LafeLabs/trashScope/geometron/symbolfeed/symbol1676215833.png

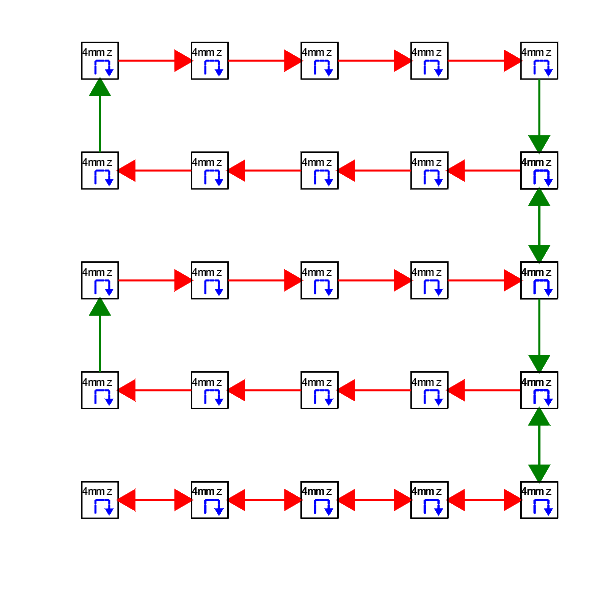
geometron/symbolfeed/symbol1676215833.png
