LafeLabs/trashScope/geometron/symbolfeed/symbol1676500387.png

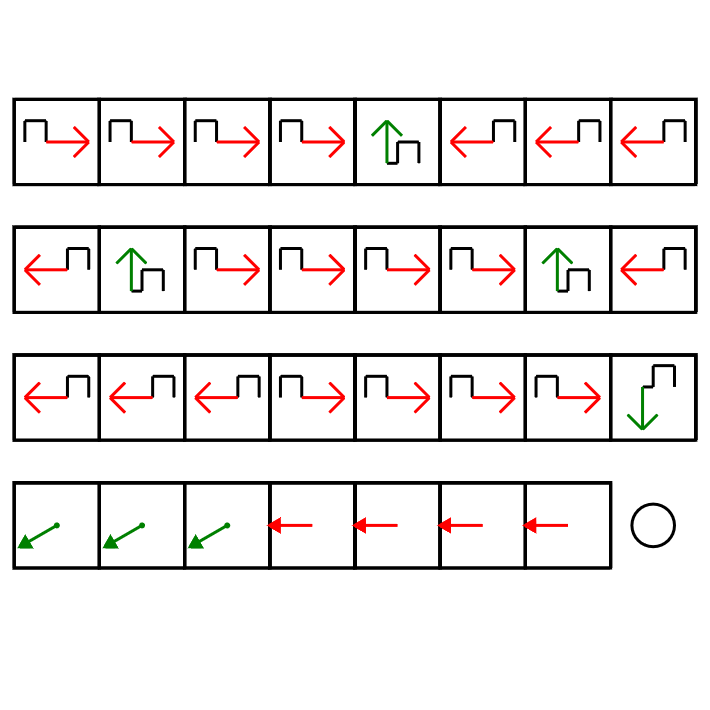
geometron/symbolfeed/symbol1676500387.png
