LafeLabs/trashScope/geometron/symbolfeed/symbol1676500932.png

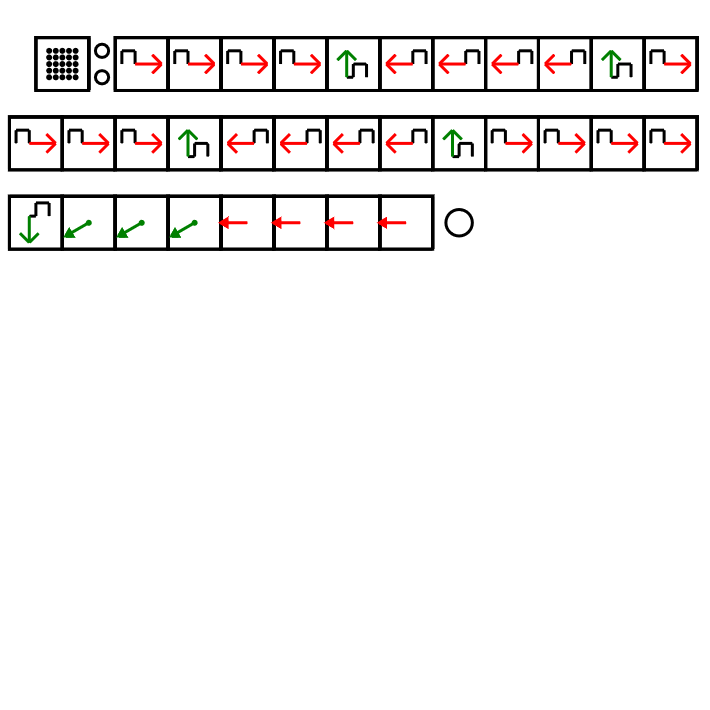
geometron/symbolfeed/symbol1676500932.png
