LafeLabs/trashScope/geometron/symbolfeed/symbol1676500959.png

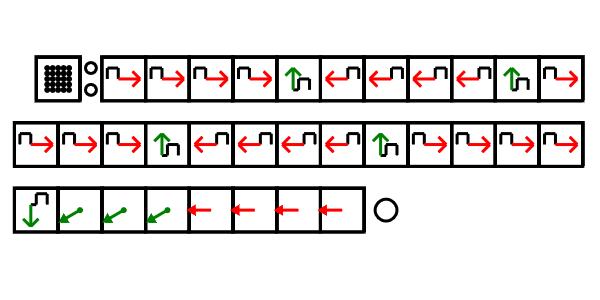
geometron/symbolfeed/symbol1676500959.png
