LafeLabs/trashScope/geometron/symbolfeed/symbol1676501370.png

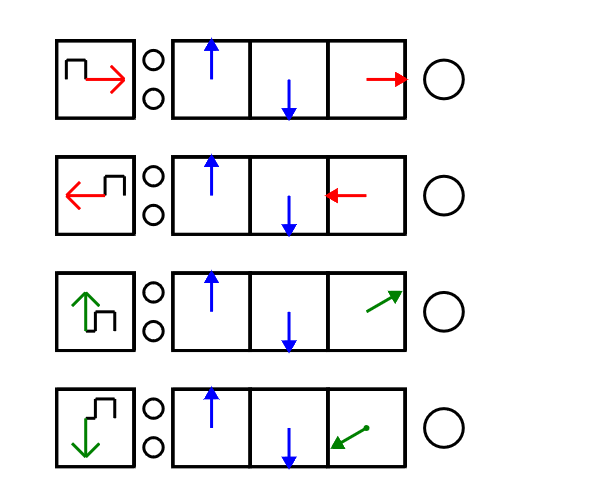
geometron/symbolfeed/symbol1676501370.png
