LafeLabs/trashScope/pcb/arduino-shield-xyz-stepper-v3.brd

## EAGLE design pcb/arduino-shield-xyz-stepper-v3.brd (2023-02-11)

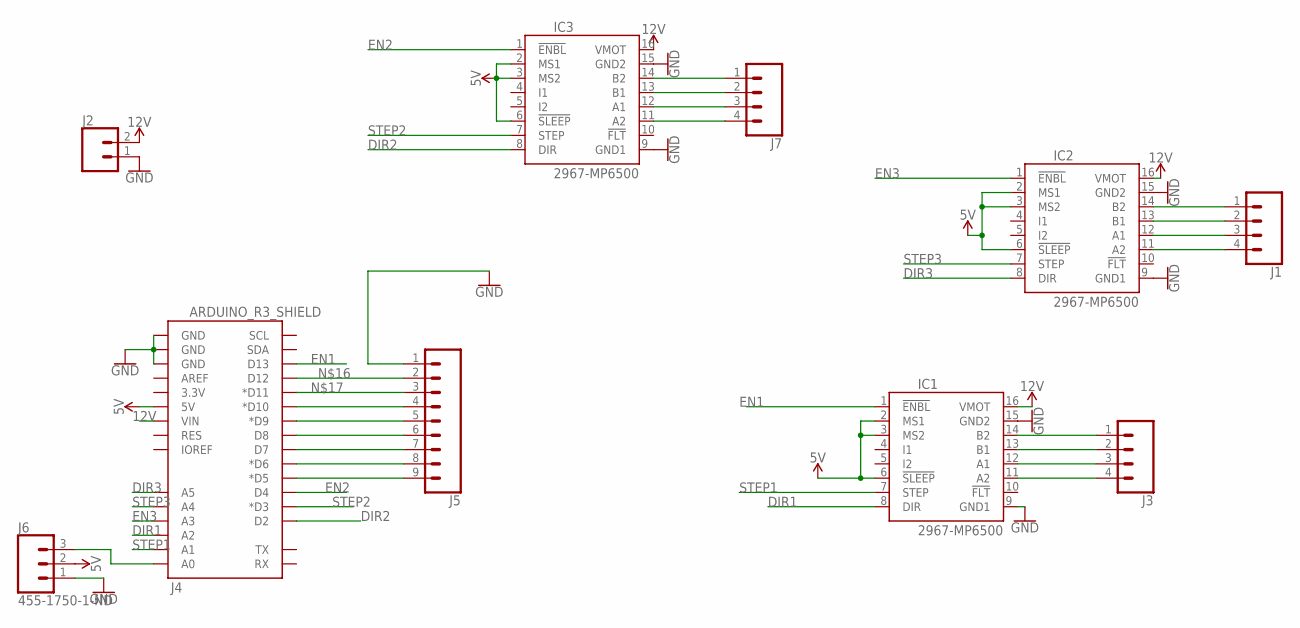
[picture p6: schematic arduino-shield-xyz-stepper-v3.sch]

Parts:
IC1, IC2, IC3: 2967-MP6500; MP6500
J1, J3, J7: CONN_04; 1X04
J2: CONN_02; 1X02
J4: ARDUINO_R3_SHIELD; UNO_R3_SHIELD
J5: CONN_09; 1X09
J6: 455-1750-1-ND; 1X03

Connections:
5V: IC1.2 (MS1), IC1.3 (MS2), IC1.6 (!SLEEP), IC2.2 (MS1), IC2.3 (MS2), IC2.6 (!SLEEP), IC3.2 (MS1), IC3.3 (MS2), IC3.6 (!SLEEP), J4.5V, J6.2
12V: IC1.16 (VMOT), IC2.16 (VMOT), IC3.16 (VMOT), J2.2, J4.VIN
DIR1: IC1.8 (DIR), J4.A2
DIR2: IC3.8 (DIR), J4.D2
DIR3: IC2.8 (DIR), J4.A5
EN1: IC1.1 (!ENBL), J4.D13
EN2: IC3.1 (!ENBL), J4.D4
EN3: IC2.1 (!ENBL), J4.A3
GND: IC1.9 (GND1), IC1.15 (GND2), IC2.9 (GND1), IC2.15 (GND2), IC3.9 (GND1), IC3.15 (GND2), J2.1, J4.GND@0 (GND), J4.GND@1 (GND), J4.GND@2 (GND), J5.1, J6.1
unnamed: IC3.14 (B2), J7.1
unnamed: IC3.13 (B1), J7.2
unnamed: IC1.14 (B2), J3.1
unnamed: IC1.13 (B1), J3.2
unnamed: IC1.12 (A1), J3.3
unnamed: IC1.11 (A2), J3.4
unnamed: IC2.14 (B2), J1.1
unnamed: IC2.13 (B1), J1.2
unnamed: IC2.12 (A1), J1.3
unnamed: IC2.11 (A2), J1.4
unnamed: IC3.12 (A1), J7.3
unnamed: IC3.11 (A2), J7.4
unnamed: J4.A0, J6.3
unnamed: J4.D12, J5.2
unnamed: J4.D11 (*D11), J5.3
unnamed: J4.D10 (*D10), J5.4
unnamed: J4.D9 (*D9), J5.5
unnamed: J4.D8, J5.6
unnamed: J4.D7, J5.7
unnamed: J4.D6 (*D6), J5.8
unnamed: J4.D5 (*D5), J5.9
STEP1: IC1.7 (STEP), J4.A1
STEP2: IC3.7 (STEP), J4.D3 (*D3)
STEP3: IC2.7 (STEP), J4.A4

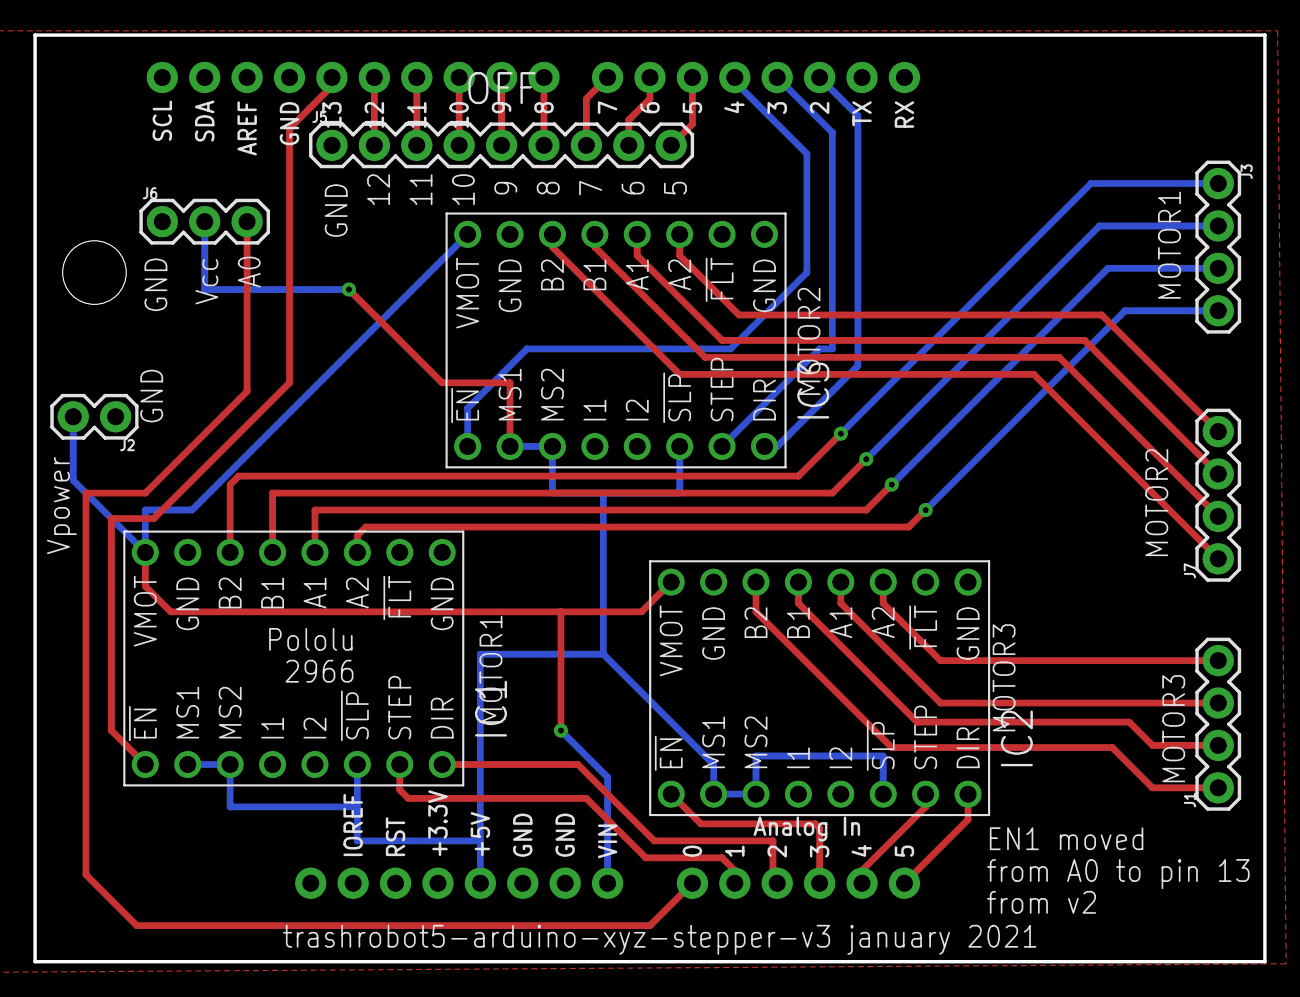
[picture p7: board arduino-shield-xyz-stepper-v3.brd from above]

Board: 2 copper layers, 73.7 x 55.5 mm, 10 parts (0 on the bottom side), 33 nets.
